AnshMi2674/TSC_V1/Schematic.png

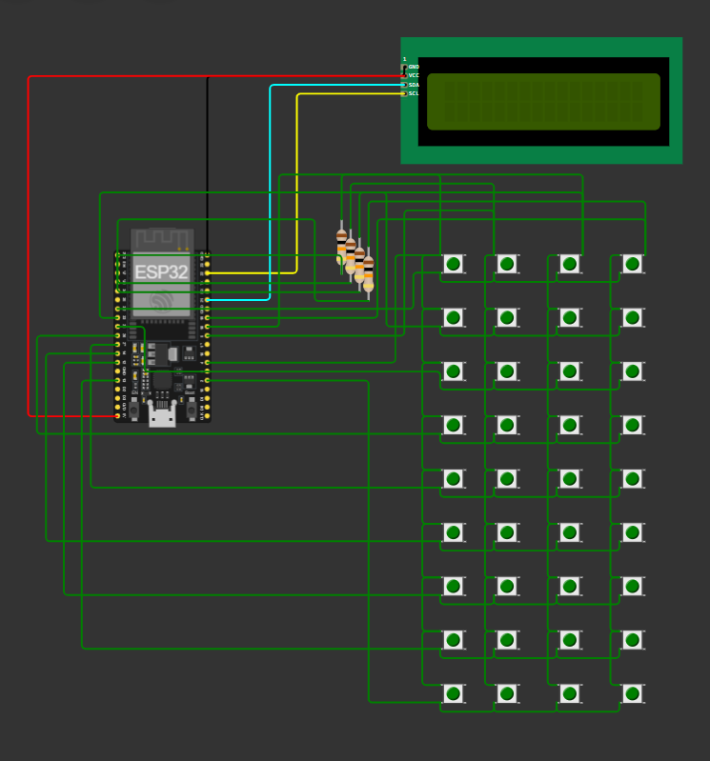
Schematic.png
